brendena/apple_pi_tv/Images/apple_pi_tv_board2.png

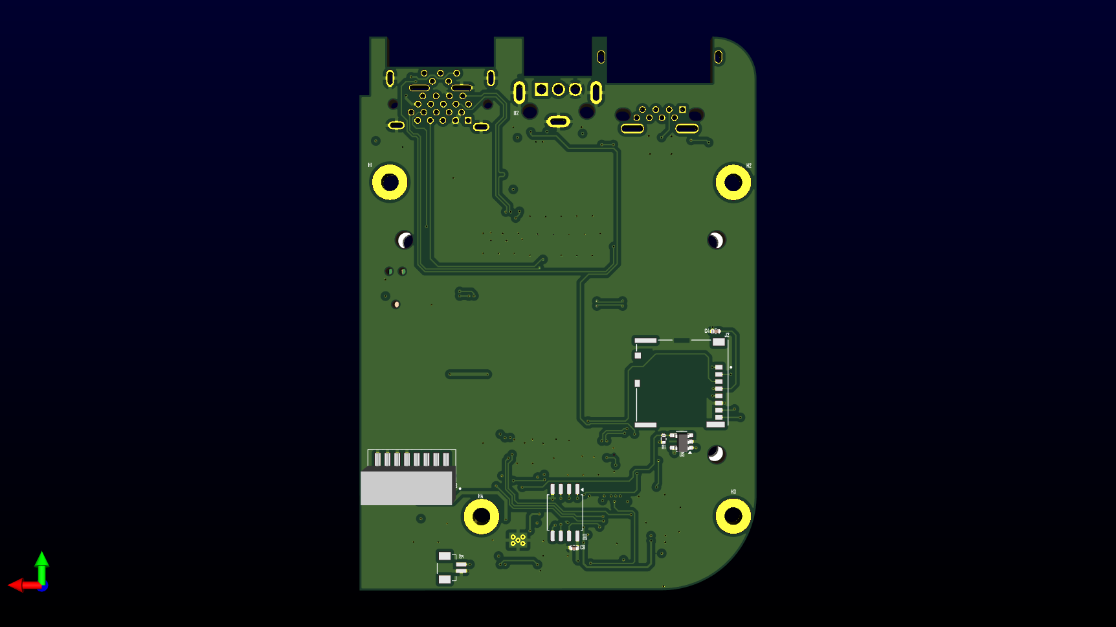
Images/apple_pi_tv_board2.png
