brendena/apple_pi_tv/Images/apple_pi_tv_board.png

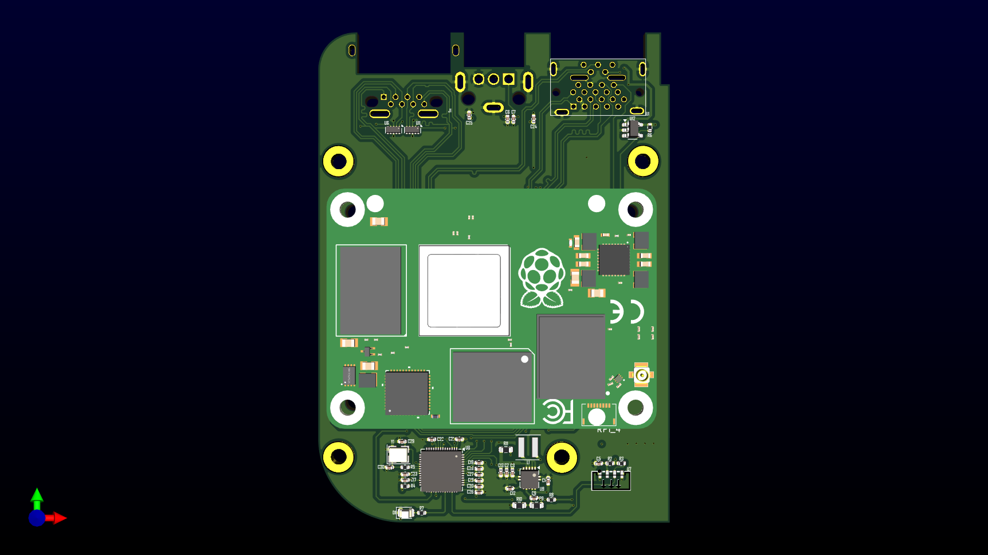
Images/apple_pi_tv_board.png
