brendena/apple_pi_tv/README.md

# apple pi tv
The goal is to make a replacement board for the apple tv using a raspberry pi CM4
