brendena/apple_pi_tv/board/apple_tv_hdmi_usb.png

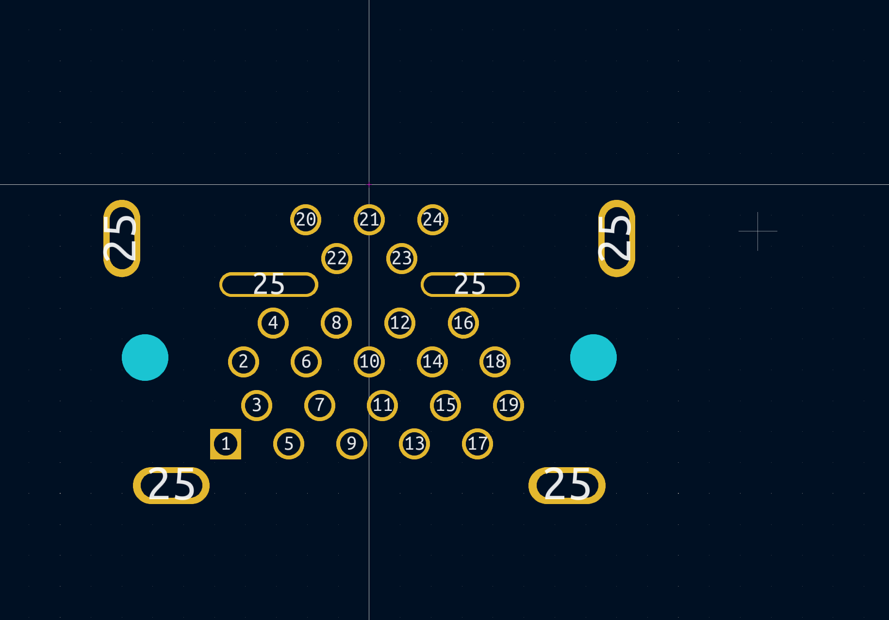
board/apple_tv_hdmi_usb.png
