brendena/apple_pi_tv/doc/images/layers.png

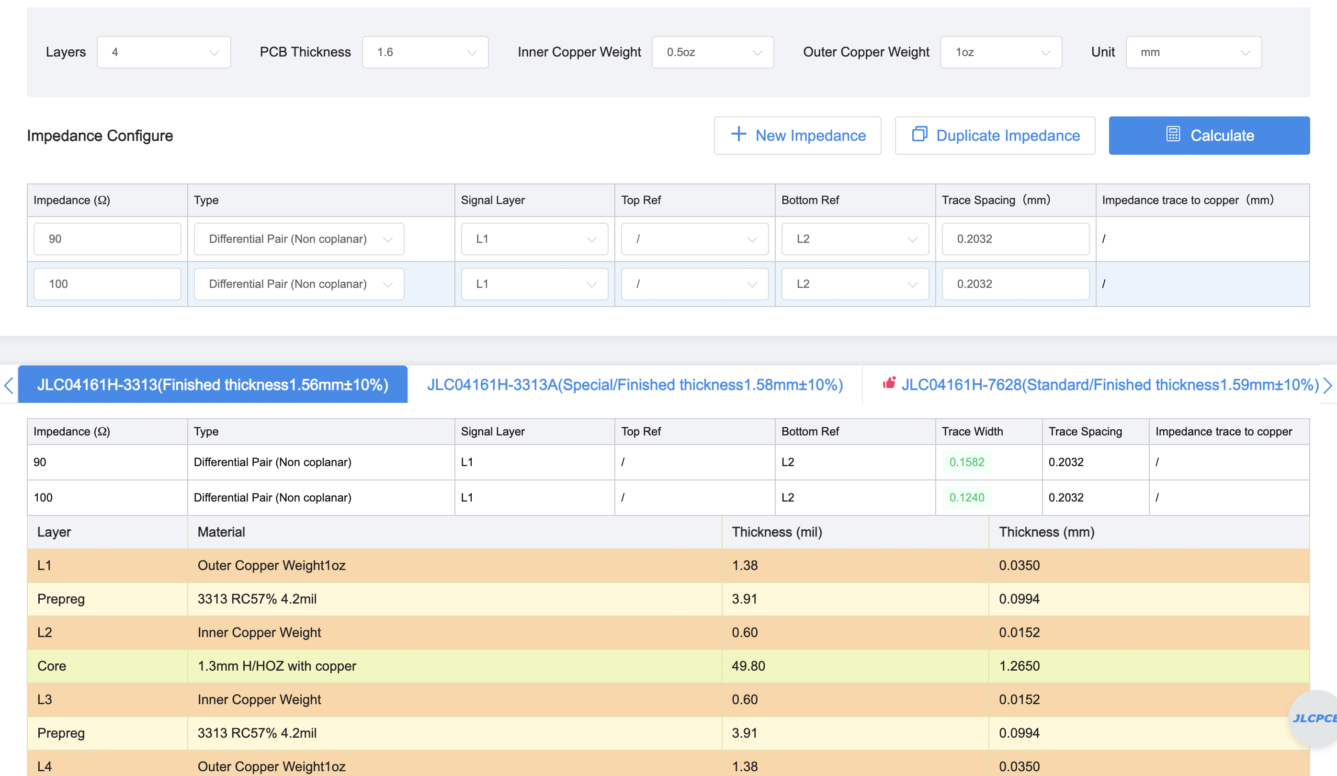
doc/images/layers.png
