brendena/apple_pi_tv/doc/images/ti_power_supply.png

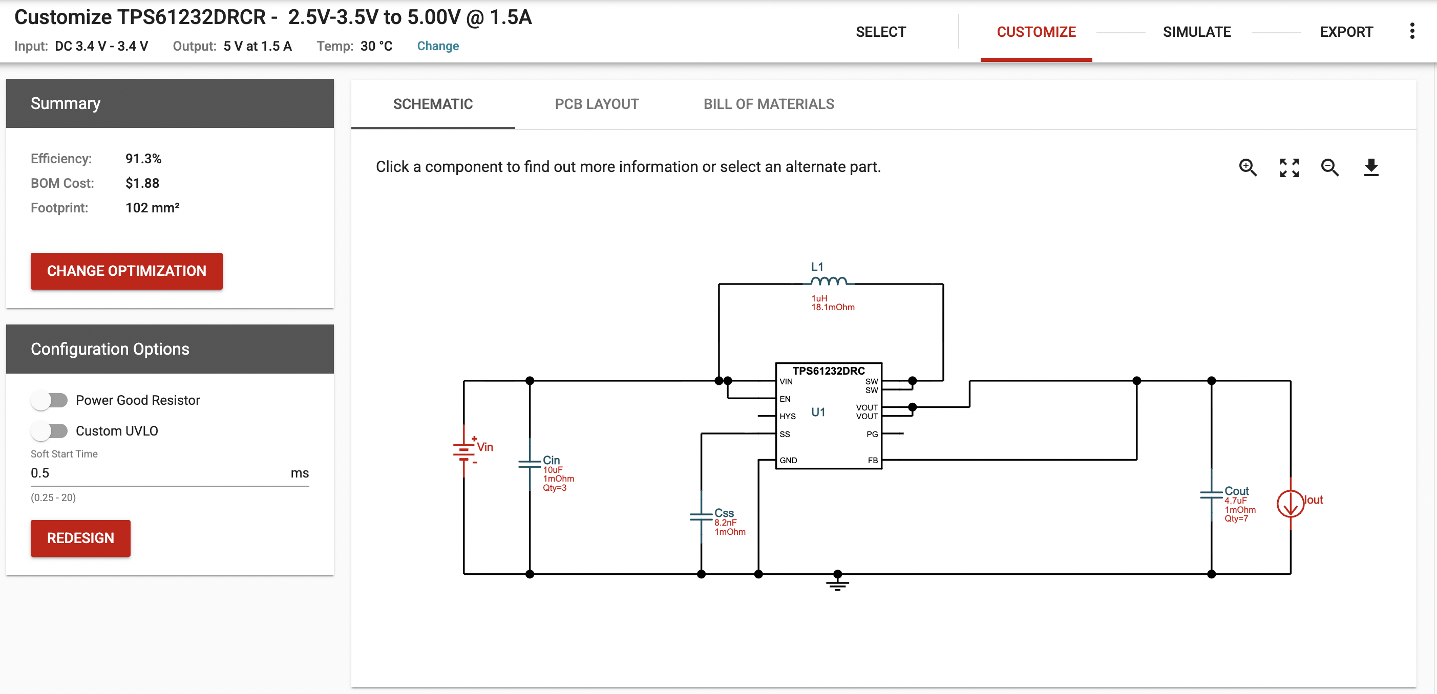
doc/images/ti_power_supply.png
