brendena/apple_pi_tv/doc/scans/back.jpg

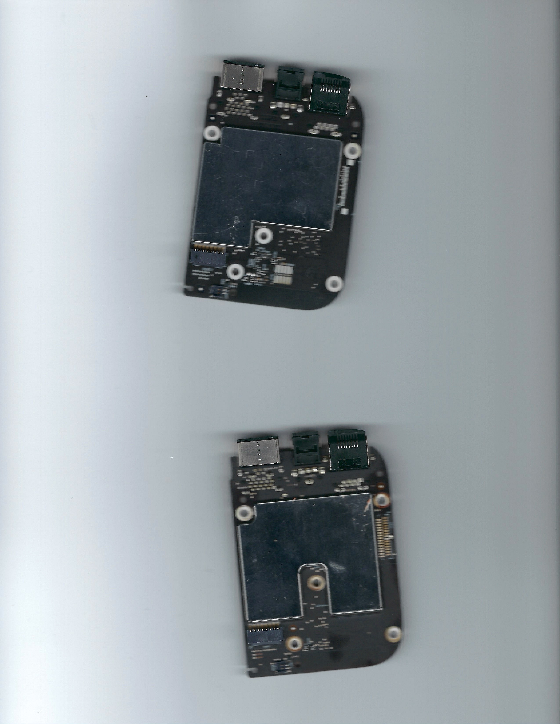
doc/scans/back.jpg
