brendena/apple_pi_tv/doc/scans/front.jpg

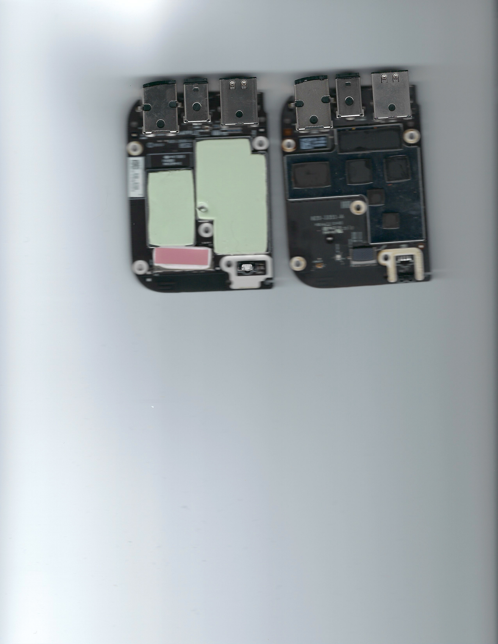
doc/scans/front.jpg
