brendena/apple_pi_tv/Images/apple_pi_tv_board5.png

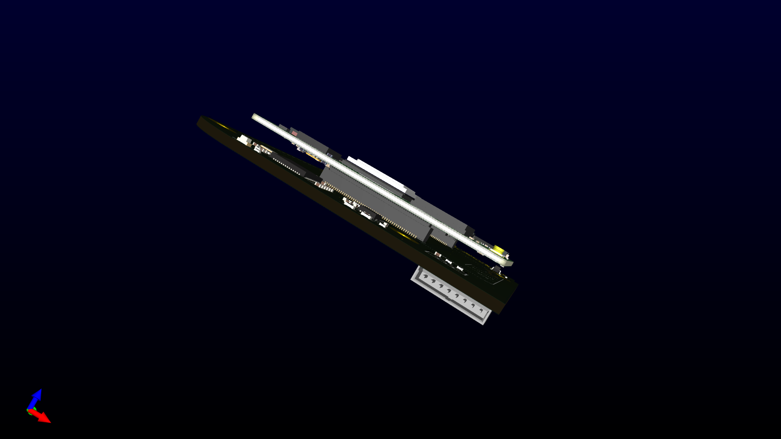
Images/apple_pi_tv_board5.png
