brendena/apple_pi_tv/Images/apple_pi_tv_board6.png

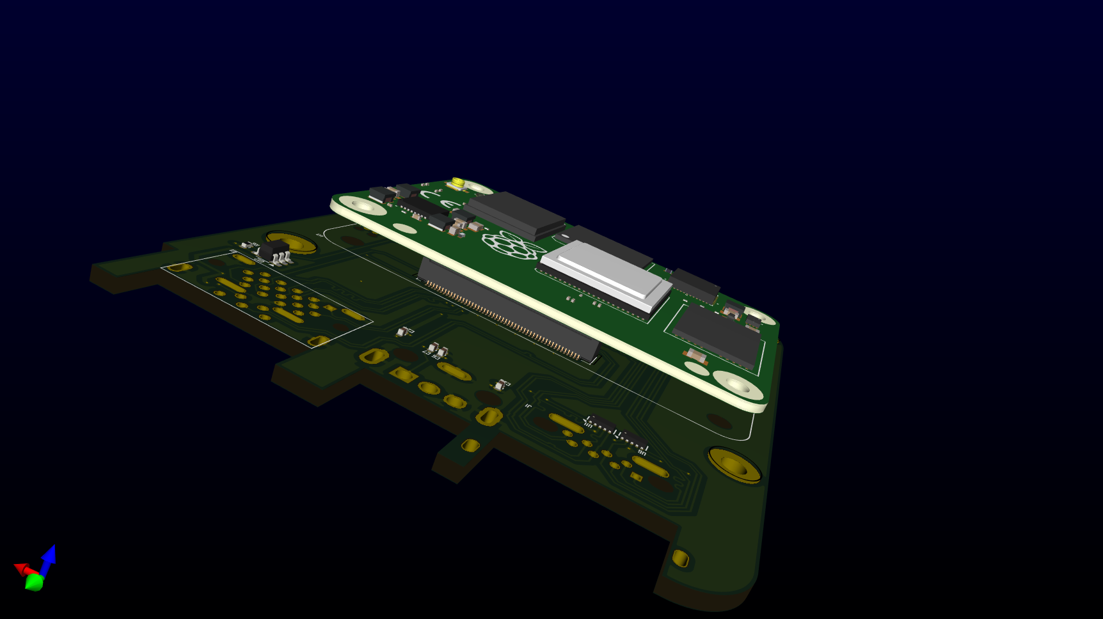
Images/apple_pi_tv_board6.png
