brendena/apple_pi_tv/board/apple_pi_tv_board.step

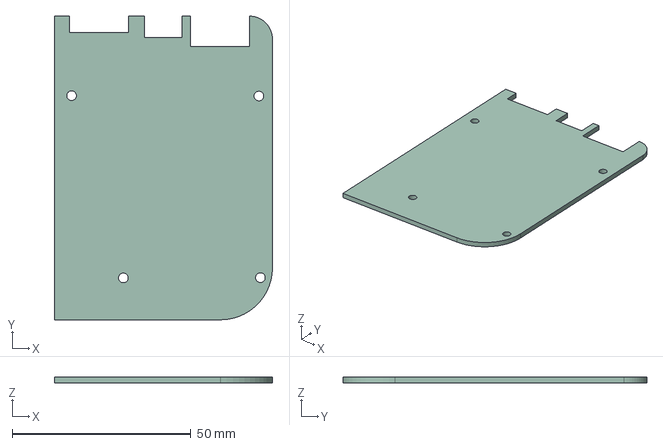
[picture p12: CAD file, 2024-07-14]
board/apple_pi_tv_board.step
61.0 x 85.0 x 1.60 mm
