brendena/apple_pi_tv/board/parts/DF40C-100DS-0.4V_51_/DF40C-100DS-0.4V_51_.step

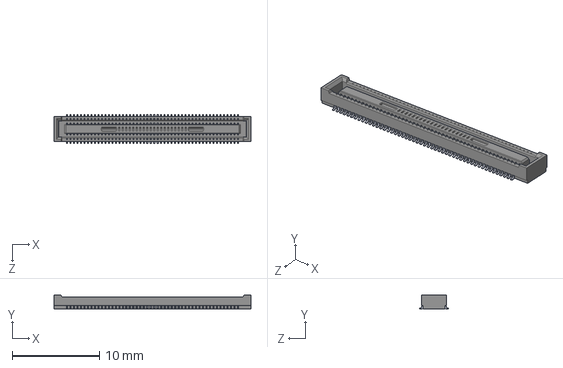
[picture p13: CAD file, 2026-08-02]
board/parts/DF40C-100DS-0.4V_51_/DF40C-100DS-0.4V_51_.step
22.6 x 1.65 x 3.38 mm
