brendena/apple_pi_tv/board/parts/H5007NL/H5007NL.step

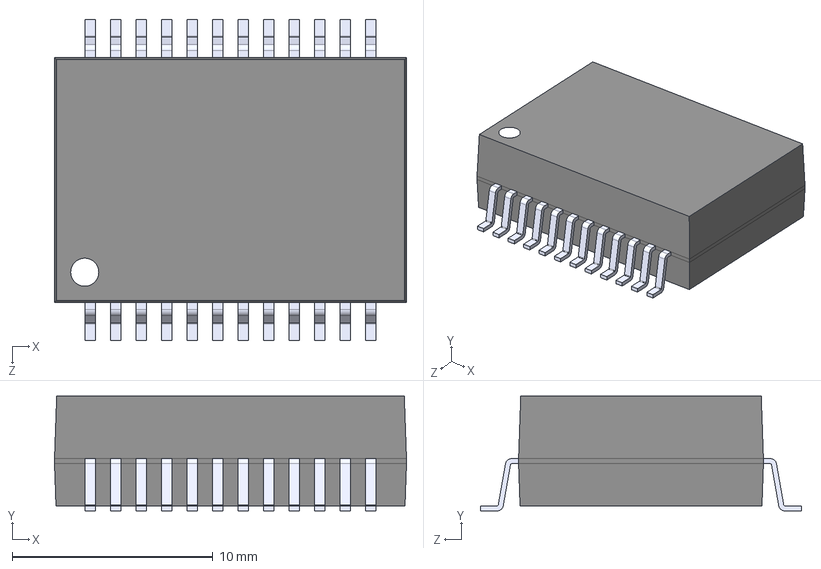
[picture p14: CAD file, 2025-11-13]
board/parts/H5007NL/H5007NL.step
17.5 x 5.72 x 16.0 mm
