brendena/apple_pi_tv/board/parts/RP2350_KiCad/RP2350B-QFN80.step

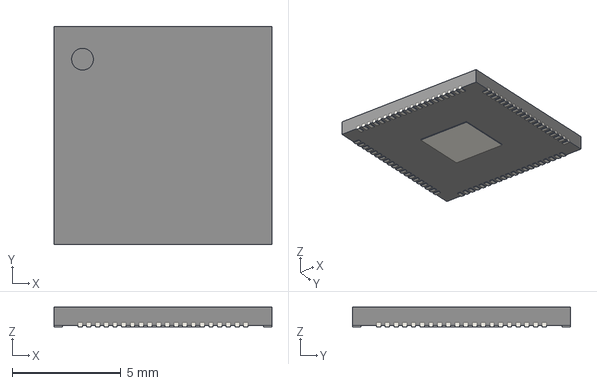
[picture p15: CAD file, 2025-09-10]
board/parts/RP2350_KiCad/RP2350B-QFN80.step
10.0 x 10.0 x 0.9 mm
