brendena/apple_pi_tv/board/parts/TF-01A/TF-01A.step

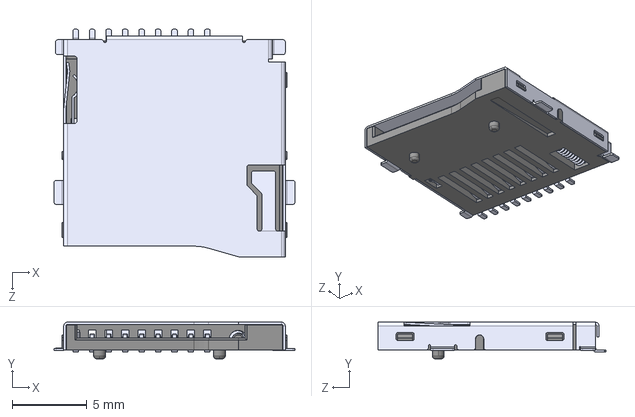
[picture p16: CAD file, 2025-12-14]
board/parts/TF-01A/TF-01A.step
16.1 x 2.45 x 15.2 mm
