brendena/apple_pi_tv/board/parts/RP2350_KiCad/RP2350A-QFN60.step

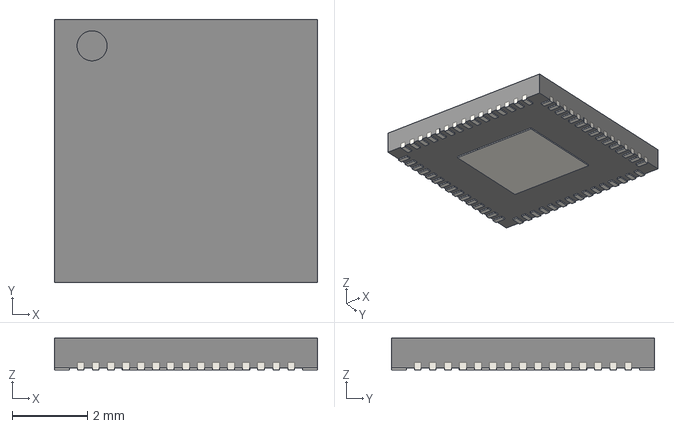
[picture p17: CAD file, 2025-09-10]
board/parts/RP2350_KiCad/RP2350A-QFN60.step
7.00 x 7.00 x 0.85 mm
