brendena/apple_pi_tv/changes.md

Changes

### 0.1 -> 0.2
* hdmi - Pins 2 and 3 had to swap - done
* hdmi,TOSLINK,Ethernet - many of the holes needed to be moved
* Ethernet - needed to be pushed back a lot
* many resisters needed to be moved for the pi pico.  They were just in the wrong spot
* TOSLINK - needed to be flipped horizontally
