brendena/apple_pi_tv/apple_pi_tv_board.pdf

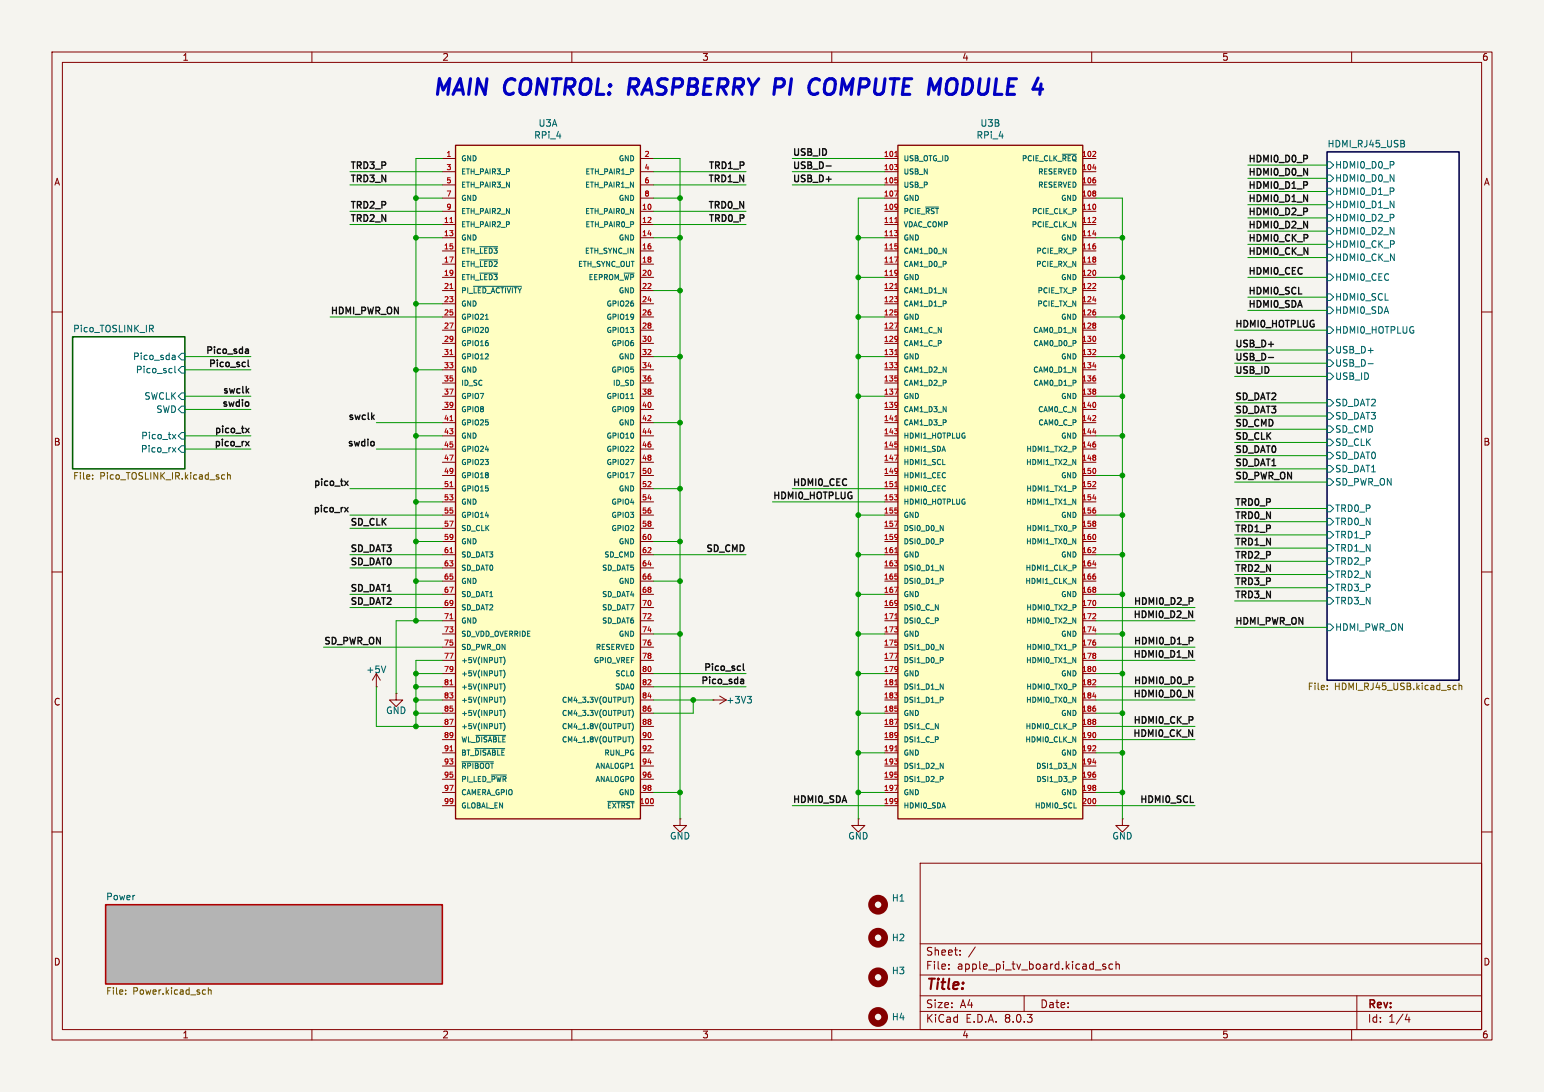
[picture p18: page 1]

File: HDMI_RJ45_USB.kicad_sch Power File: Power.kicad_sch

Id: 1/4 Title: File: apple_pi_tv_board.kicad_sch Sheet: /

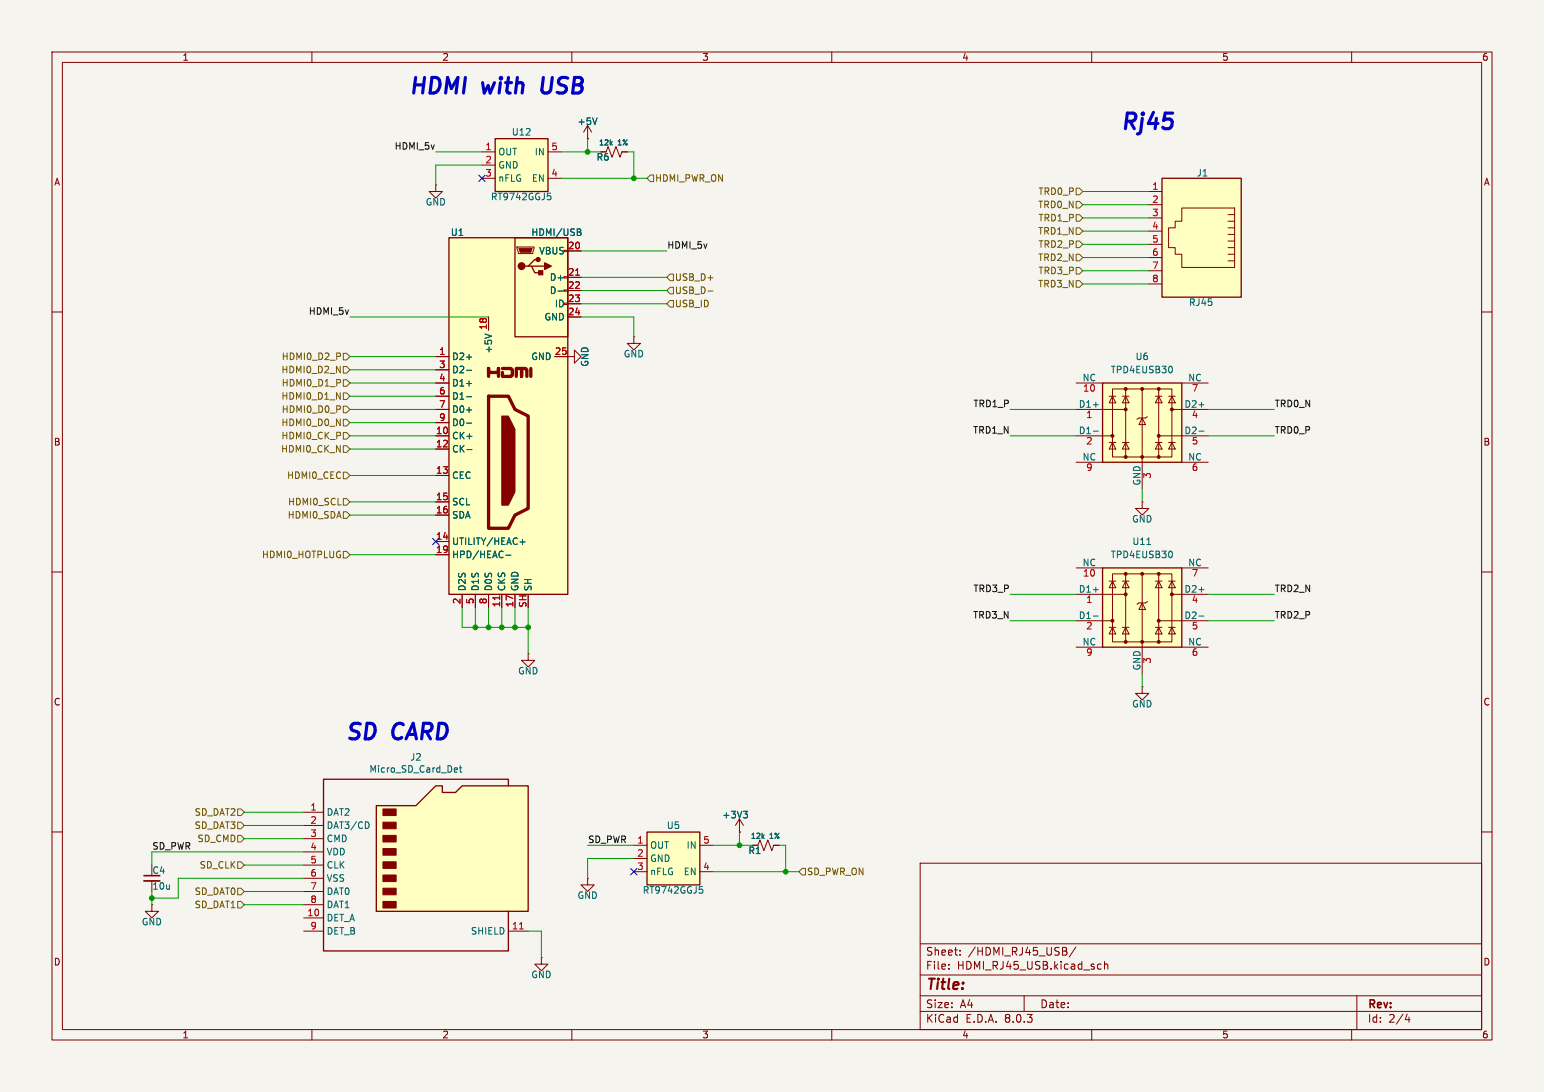
[picture p19: page 2]

Id: 2/4 Title: File: HDMI_RJ45_USB.kicad_sch Sheet: /HDMI_RJ45_USB/ GND

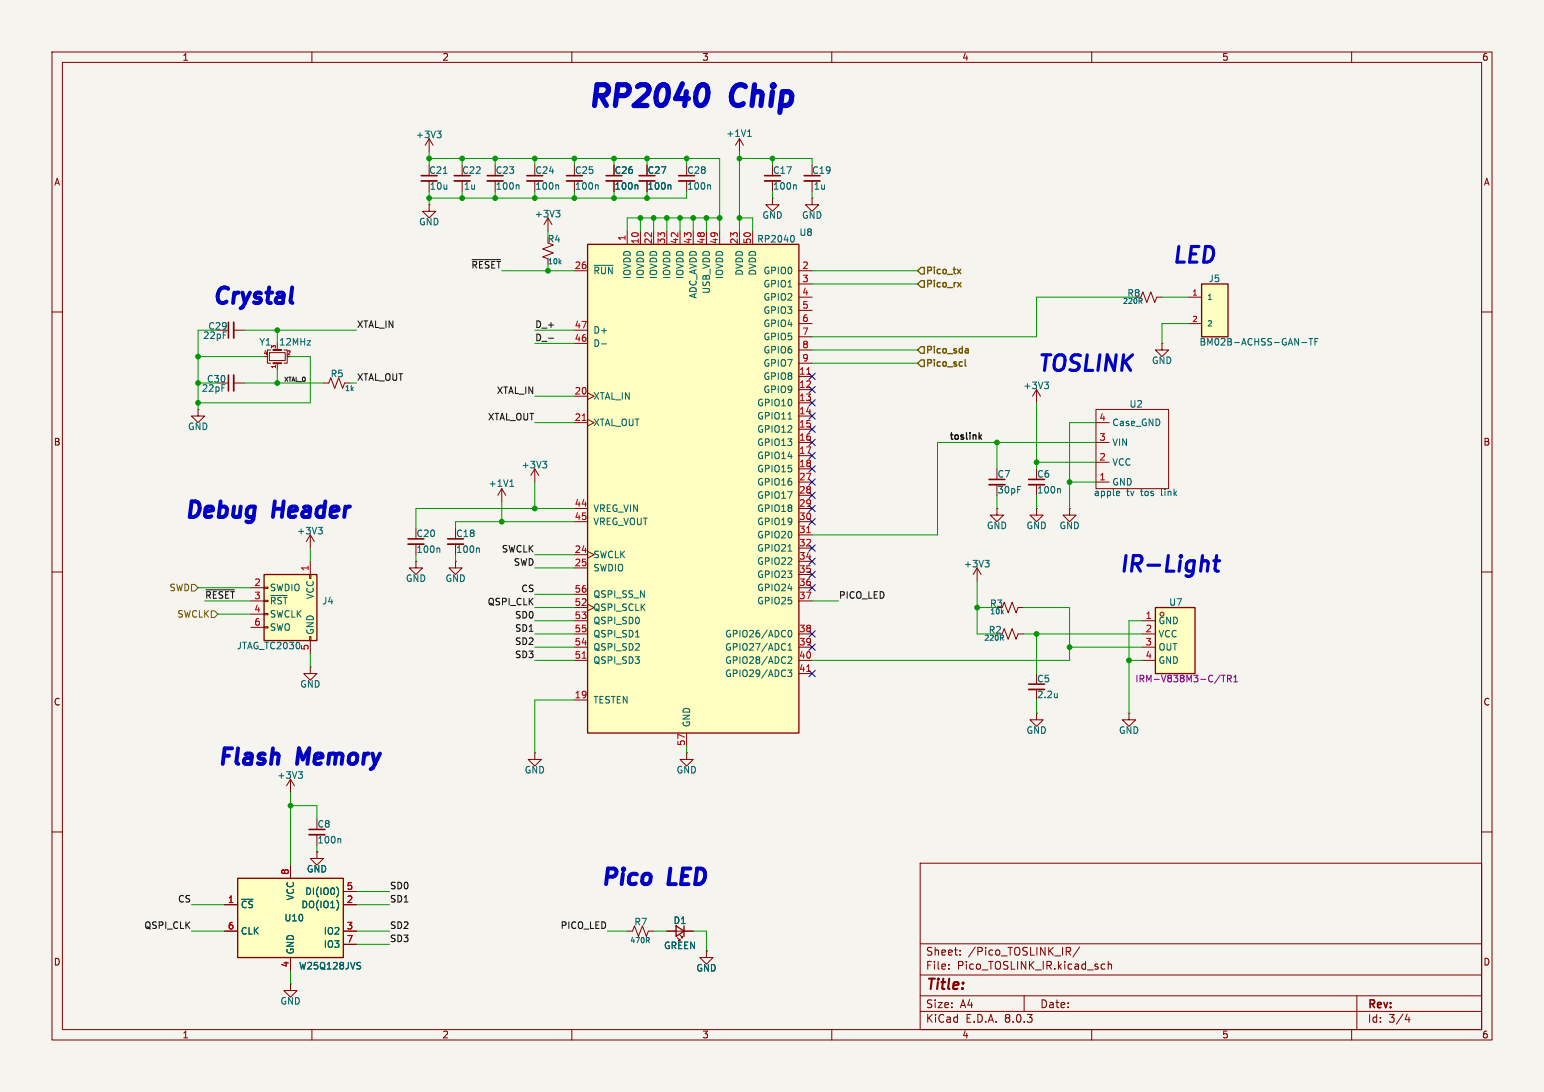
[picture p20: page 3]

1 IOVDD 10 GPIO8 11 GPIO9 12 GPIO10 13 GPIO11 14 GPIO12 15 GPIO13 16 GPIO14 17 GPIO15 18 TESTEN 19 GPIO0 2 XTAL_IN 20 XTAL_OUT 21 IOVDD 22 DVDD 23 SWCLK 24 SWDIO 25 ~{RUN} 26 GPIO16 27 GPIO17 28 GPIO18 29 GPIO1 3 GPIO19 30 GPIO20 31 GPIO21 32 IOVDD 33 GPIO22 34 GPIO23 35 GPIO24 36 GPIO25 37 GPIO26/ADC0 38 GPIO27/ADC1 39 GPIO2 4 GPIO28/ADC2 40 GPIO29/ADC3 41 IOVDD 42 ADC_AVDD 43 VREG_VIN 44 VREG_VOUT 45 D- 46 D+ 47 USB_VDD 48 IOVDD 49 GPIO3 5 DVDD 50 QSPI_SD3 51 QSPI_SCLK 52 QSPI_SD0 53 QSPI_SD2 54 QSPI_SD1 55 QSPI_SS_N 56 GND 57 GPIO4 6 GPIO5 7 GPIO6 8 GPIO7 9U8 RP2040 C19

apple tv tos link +3V3 GND

1 SWDIO 2 ~{RST} 3 SWCLK 4 GND

Id: 3/4 Title: File: Pico_TOSLINK_IR.kicad_sch Sheet: /Pico_TOSLINK_IR/

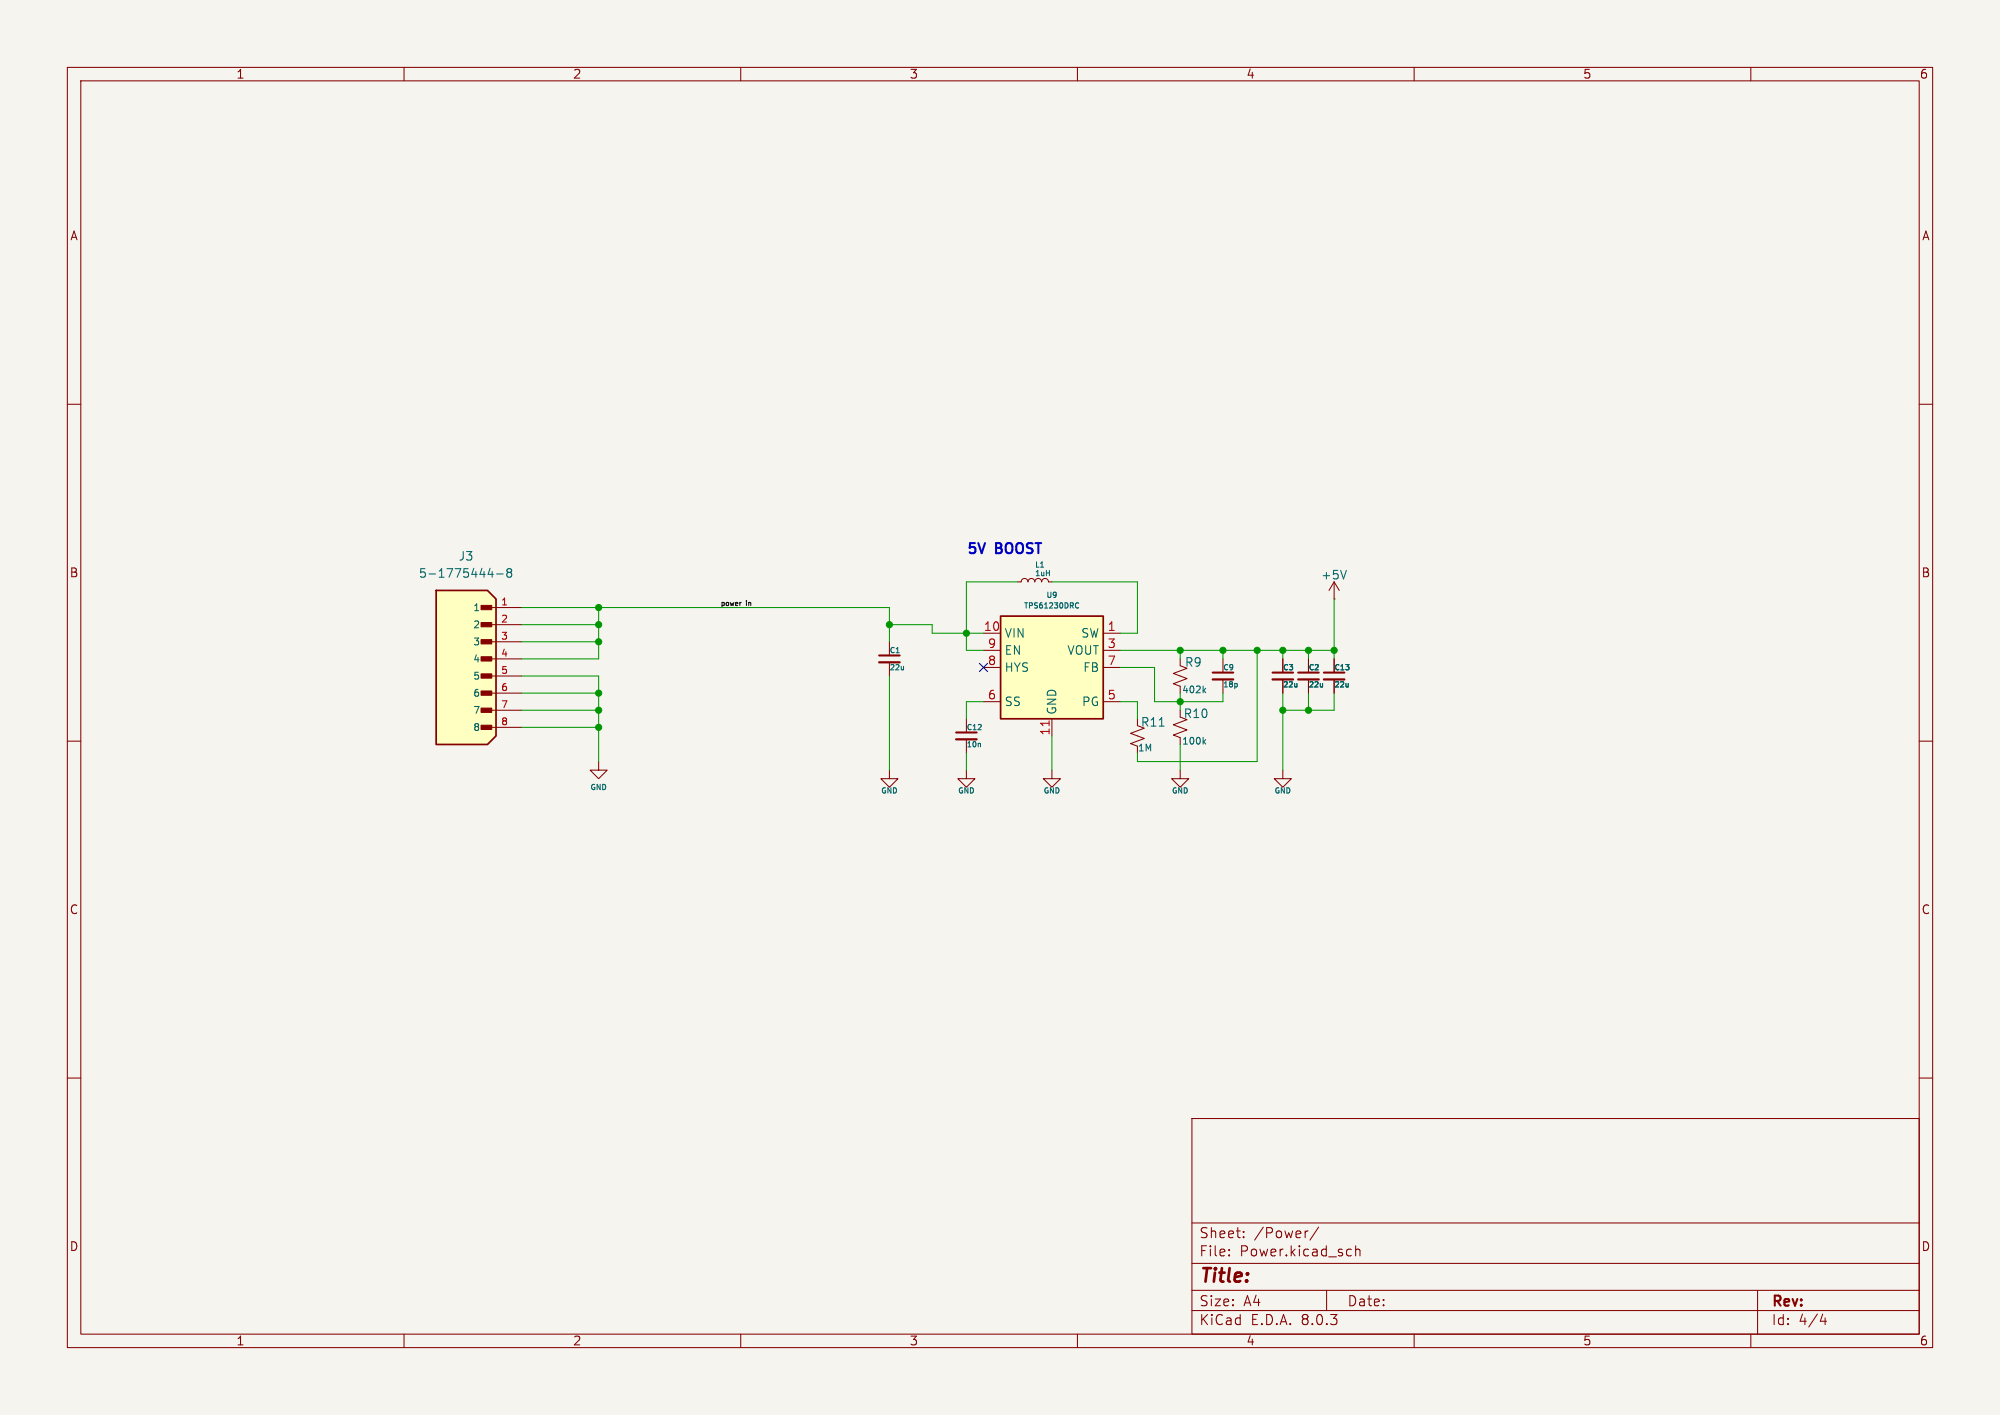
[picture p21: page 4]

Id: 4/4 Title: File: Power.kicad_sch Sheet: /Power/
