brendena/apple_pi_tv/board/apple_pi_tv_board.kicad_pcb

## KiCad design board/apple_pi_tv_board.kicad_pcb (2026-08-02)

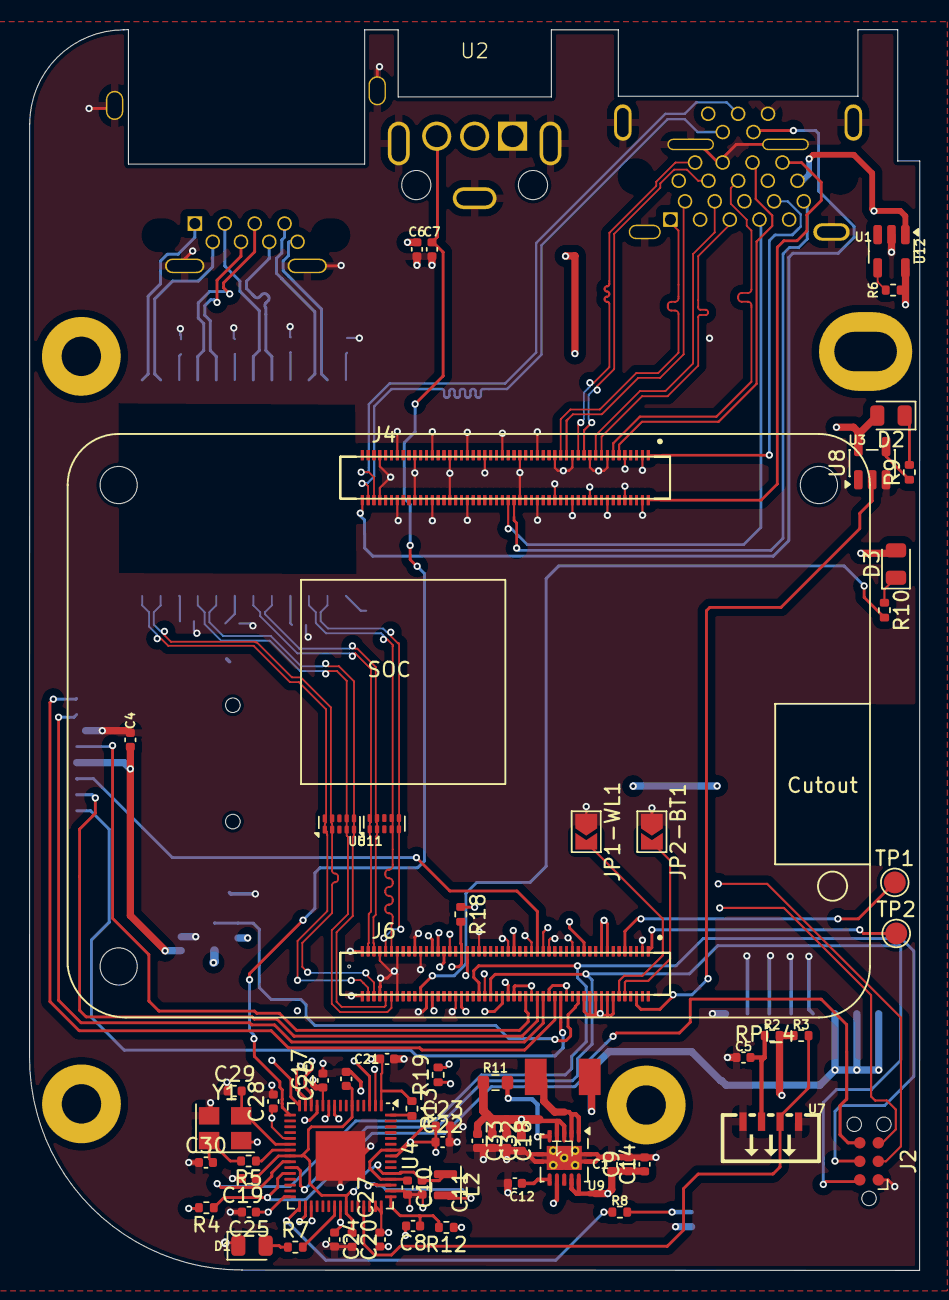
[picture p22: board apple_pi_tv_board.kicad_pcb from above]

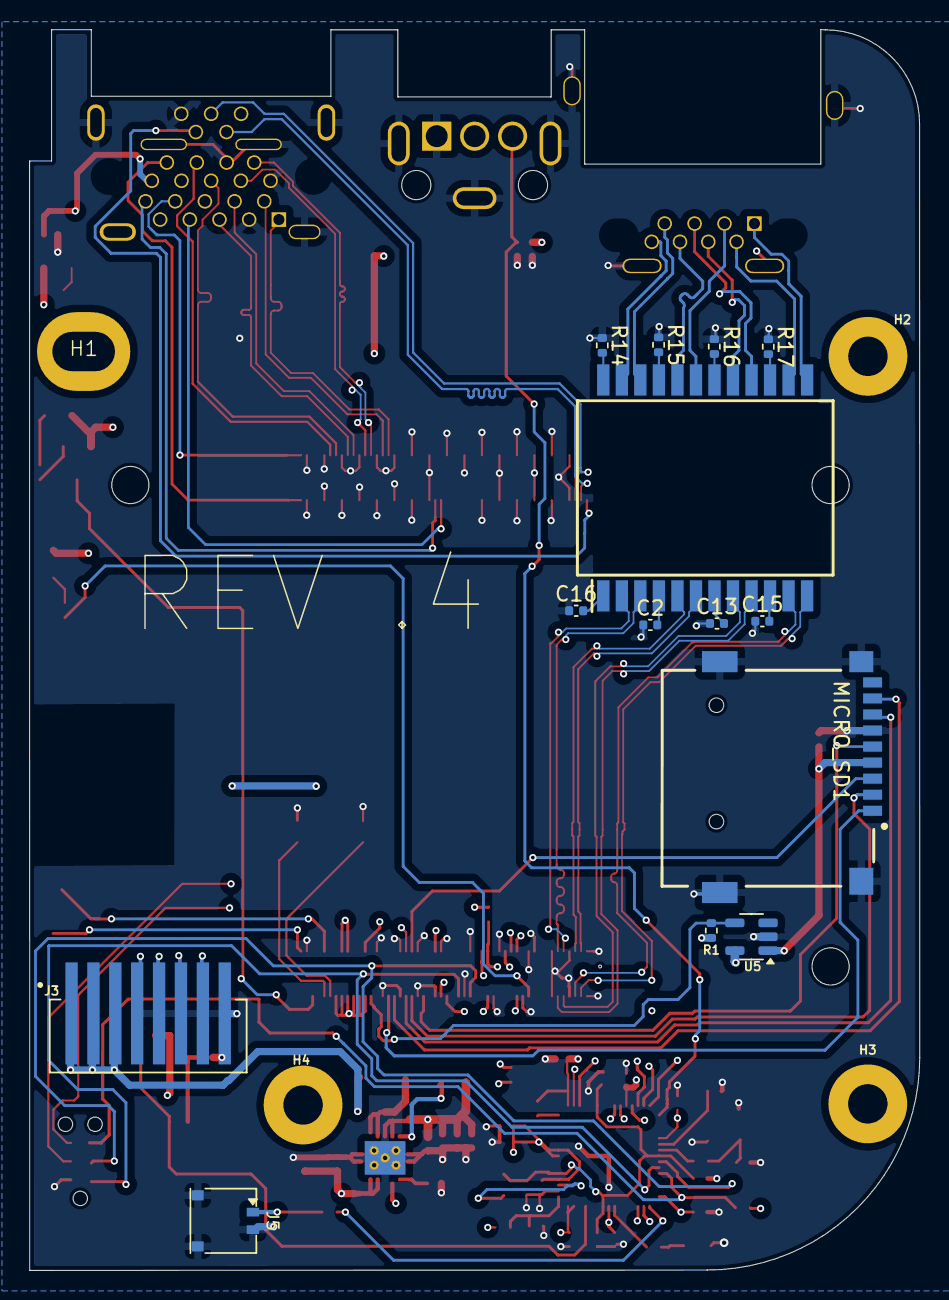
[picture p23: board apple_pi_tv_board.kicad_pcb from below]

Board: 4 copper layers, 61.0 x 85.1 mm, 84 parts (18 on the bottom side), 93 nets.

Parts:
C1, C4, C9, C14: 10u; C_0402_1005Metric
C2, C13, C15, C16: 0.1uf; C_0402_1005Metric
C3, C8, C10, C11, C18, C19: 4.7u; C_0402_1005Metric
C5: 2.2u; C_0402_1005Metric
C6, C17, C20, C21, C22, C23, C24, C25, C26, C27, C28: 100n; C_0402_1005Metric
C7: 30pF; C_0402_1005Metric
C12: 8.2nf; C_0402_1005Metric
C29, C30: 15pF; C_0402_1005Metric
C32, C33: 22u; C_0402_1005Metric
D1: GREEN; LED_0805_2012Metric
D2, D3: LED_Small; LED_0805_2012Metric
H1: MountingHole; ExtendedMountingHole
H2, H3, H4: MountingHole; MountingHole_2.7mm_Pad
J1: RJ45_Shielded; apple_tv_ethernet
J2: Dev_port; Tag-Connect_TC2030-IDC-NL_2x03_P1.27mm_Vertical
J3: 5-1775444-8; TE_5-1775444-8
J4, J6: DF40C-100DS-0.4V_51_; HIROSE_DF40C-100DS-0.4V_51_
J5: HDGC1202WR-S-2P; HDGC1202WR-S-02P
JP1-WL1, JP2-BT1: SolderJumper_2_Open; SolderJumper-2_P1.3mm_Open_TrianglePad1.0x1.5mm
L1: 1uH; MDA4020
L2: 3.3u; L_Murata_DFE201610P
MICRO_SD1: TF-01A
R1, R6: 12k 1%; R_0402_1005Metric
R2, R8, R18, R19: 220R; R_0402_1005Metric
R3, R4: 10k; R_0402_1005Metric
R5, R9, R10: 1k; R_0402_1005Metric
R7: 10K R; R_0402_1005Metric
R11: 100K; R_0603_1608Metric
R12: 33; R_0402_1005Metric
R13: 10K; R_0402_1005Metric
R14, R15, R16, R17: 75; R_0402_1005Metric
T1: H5007NL; SOIC127P1600X551-24N
TP1: RUN_PG; TestPoint_Pad_D1.5mm
TP2: Extrst; TestPoint_Pad_D1.5mm
U1: HDMI/USB; apple_tv_hdmi_usb
U2: apple tv tos link; apple_tv_tos_link
U3: RPi_4; RPI-CM4
U4: RP2354A; QFN-60-1EP_7x7mm_P0.4mm_EP3.4x3.4mm
U5, U12: RT9742GGJ5; SOT-23-5
U6, U11: TPD4EUSB30; USON-10_2.5x1.0mm_P0.5mm
U7: IRM-V838M3-C/TR1; OPTO-SMD_IRM-V838M3-C-TR1
U8: 74LVC1G07; SOT-23-5
U9: TPS61232DRC; Texas_S-PVSON-N10_ThermalVias
Y1: ABM8-272-T3; Crystal_SMD_3225-4Pin_3.2x2.5mm

Connections:
+1V1: C11.1, C17.1, C19.1, C20.1, L2.1, U4.6 (DVDD), U4.23 (DVDD), U4.39 (DVDD), U4.50 (VREG_FB)
+3V3: C6.1, C10.1, C21.1, C22.1, C23.1, C24.1, C25.1, C26.1, C27.1, C28.1, D2.2 (A), D3.2 (A), R1.1, R2.1, R3.1, R4.2, R12.1, R13.1, R18.1, R19.1, U2.2 (VCC), U3.78 (GPIO_VREF), U3.84 (CM4_3.3V(OUTPUT)), U3.86 (CM4_3.3V(OUTPUT)), U4.1 (IOVDD), U4.11 (IOVDD), U4.20 (IOVDD), U4.30 (IOVDD), U4.38 (IOVDD), U4.44 (ADC_AVDD), U4.45 (IOVDD), U4.49 (VREG_VIN), U4.53 (USB_OTP_VDD), U4.54 (QSPI_IOVDD), U5.5 (IN), U8.5 (VCC)
+5V: C3.1, C18.1, C32.1, C33.1, R6.1, R11.1, U3.77 (+5V(INPUT)), U3.79 (+5V(INPUT)), U3.81 (+5V(INPUT)), U3.83 (+5V(INPUT)), U3.85 (+5V(INPUT)), U3.87 (+5V(INPUT)), U9.3 (VOUT), U9.4 (VOUT), U9.7 (FB), U12.5 (IN)
/HDMI0_CEC: U1.13 (CEC), U3.151 (HDMI0_CEC)
/HDMI0_CK_N: U1.12 (CK-), U3.190 (HDMI0_CLK_N)
/HDMI0_CK_P: U1.10 (CK+), U3.188 (HDMI0_CLK_P)
/HDMI0_D0_N: U1.9 (D0-), U3.184 (HDMI0_TX0_N)
/HDMI0_D0_P: U1.7 (D0+), U3.182 (HDMI0_TX0_P)
/HDMI0_D1_N: U1.6 (D1-), U3.178 (HDMI0_TX1_N)
/HDMI0_D1_P: U1.4 (D1+), U3.176 (HDMI0_TX1_P)
/HDMI0_D2_N: U1.3 (D2-), U3.172 (HDMI0_TX2_N)
/HDMI0_D2_P: U1.1 (D2+), U3.170 (HDMI0_TX2_P)
/HDMI0_HOTPLUG: U1.19 (HPD/HEAC-), U3.153 (HDMI0_HOTPLUG)
/HDMI0_SCL: U1.15 (SCL), U3.200 (HDMI0_SCL)
/HDMI0_SDA: U1.16 (SDA), U3.199 (HDMI0_SDA)
/HDMI_PWR_ON: R6.2, U12.4 (EN)
/HDMI_RJ45_USB/HDMI_5v: U1.18 (+5V), U1.20 (VBUS), U12.1 (OUT)
/HDMI_RJ45_USB/MCT0: R14.2, T1.24 (MCT1)
/HDMI_RJ45_USB/MCT1: R15.2, T1.21 (MCT2)
/HDMI_RJ45_USB/MCT2: R16.2, T1.18 (MCT3)
/HDMI_RJ45_USB/MCT3: R17.2, T1.15 (MCT4)
/HDMI_RJ45_USB/MX0_N: J1.8, T1.23 (MX1+)
/HDMI_RJ45_USB/MX0_P: J1.7, T1.22 (MX1-)
/HDMI_RJ45_USB/MX1_N: J1.6, T1.20 (MX2+)
/HDMI_RJ45_USB/MX1_P: J1.3, T1.19 (MX2-)
/HDMI_RJ45_USB/MX2_N: J1.4, T1.17 (MX3+)
/HDMI_RJ45_USB/MX2_P: J1.5, T1.16 (MX3-)
/HDMI_RJ45_USB/MX3_N: J1.2, T1.14 (MX4+)
/HDMI_RJ45_USB/MX3_P: J1.1, T1.13 (MX4-)
/HDMI_RJ45_USB/SD_PWR: C4.1, MICRO_SD1.4 (VDD), U5.1 (OUT)
/I2S_CLK: U3.49 (GPIO18), U4.12 (GPIO8)
/I2S_LRCLK: U3.26 (GPIO19), U4.13 (GPIO9)
/I2S_OUT: U3.25 (GPIO21), U4.14 (GPIO10)
/PI_UART_TX: J2.3 (Pi_Tx), U3.51 (GPIO15)
/PI_eeprom_scl: R19.2, U3.35 (ID_SC), U4.10 (GPIO7)
/Pi_eeprom_sda: R18.2, U3.36 (ID_SD), U4.9 (GPIO6)
/Pico_TOSLINK_IR/PICO_LED: R7.2, U4.37 (GPIO25)
/Pico_TOSLINK_IR/Pico_blinky: R8.1, U4.31 (GPIO19)
/Pico_TOSLINK_IR/XTAL_IN: C29.2, U4.21 (XIN), Y1.3
/Pico_TOSLINK_IR/XTAL_O: C30.2, R5.2, Y1.1
/Pico_TOSLINK_IR/XTAL_OUT: R5.1, U4.22 (XOUT)
/Pico_TOSLINK_IR/toslink: C7.1, U2.3 (VIN), U4.16 (GPIO12)
/Pico_TOSLINK_IR/~RESET: J2.6 (RST), R4.1, U4.26 (RUN)
/Pico_hid_irq: U3.30 (GPIO6), U4.15 (GPIO11)
/Pico_scl: U3.28 (GPIO13), U4.33 (GPIO21)
/Pico_sda: U3.38 (GPIO11), U4.32 (GPIO20)
/Power/power in: C1.1, C9.1, C14.1, J3.1, J3.2, J3.3, L1.1, U9.9 (EN), U9.10 (VIN)
/SD_CLK: MICRO_SD1.5 (CLK), U3.57 (SD_CLK)
/SD_CMD: MICRO_SD1.3 (CMD), U3.62 (SD_CMD)
/SD_DAT0: MICRO_SD1.7 (DAT0), U3.63 (SD_DAT0)
/SD_DAT1: MICRO_SD1.8 (DAT1), U3.67 (SD_DAT1)
/SD_DAT2: MICRO_SD1.1 (DAT2), U3.69 (SD_DAT2)
/SD_DAT3: MICRO_SD1.2 (CD/DAT3), U3.61 (SD_DAT3)
/SD_PWR_ON: R1.2, U3.75 (SD_PWR_ON), U5.4 (EN)
/TRD0_N: T1.2 (TD1+), U3.10 (ETH_PAIR0_N), U11.5 (D2-)
/TRD0_P: T1.3 (TD1-), U3.12 (ETH_PAIR0_P), U11.4 (D2+)
/TRD1_N: T1.5 (TD2+), U3.6 (ETH_PAIR1_N), U11.2 (D1-)
/TRD1_P: T1.6 (TD2-), U3.4 (ETH_PAIR1_P), U11.1 (D1+)
/TRD2_N: T1.8 (TD3+), U3.9 (ETH_PAIR2_N), U6.5 (D2-)
/TRD2_P: T1.9 (TD3-), U3.11 (ETH_PAIR2_P), U6.4 (D2+)
/TRD3_N: T1.11 (TD4+), U3.5 (ETH_PAIR3_N), U6.2 (D1-)
/TRD3_P: T1.12 (TD4-), U3.3 (ETH_PAIR3_P), U6.1 (D1+)
/USB_D+: U1.21 (D+), U3.105 (USB_P)
/USB_D-: U1.22 (D-), U3.103 (USB_N)
/USB_ID: U1.23 (ID), U3.101 (USB_OTG_ID)
/pico_rx: U3.54 (GPIO4), U4.3 (GPIO1)
/pico_tx: J2.5 (Pico_Tx), U3.64 (SD_DAT5), U4.2 (GPIO0)
/swclk: J2.4 (SWCLK), U3.41 (GPIO25), U4.24 (SWCLK)
/swdio: J2.2 (SWD), U3.45 (GPIO24), U4.25 (SWDIO)
GND: C1.2, C2.1, C3.2, C4.2, C5.2, C6.2, C7.2, C8.2, C9.2, C10.2, C11.2, C12.2, C13.1, C14.2, C15.1, C16.1, C17.2, C18.2, C19.2, C20.2, C21.2, C22.2, C23.2, C24.2, C25.2, C26.2, C27.2, C28.2, C29.1, C30.1, C32.2, C33.2, D1.1 (K), J1.SH, J2.1 (GND), J3.4, J3.5, J3.6, J3.7, J3.8, J5.2, J5.MP, JP1-WL1.1 (A), JP2-BT1.1 (A), MICRO_SD1.6 (VSS), MICRO_SD1.MP1 (SHIELD), MICRO_SD1.MP2 (SHIELD), MICRO_SD1.MP3 (SHIELD), MICRO_SD1.MP4 (SHIELD), R14.1, R15.1, R16.1, R17.1, U1.2 (D2S), U1.5 (D1S), U1.8 (D0S), U1.11 (CKS), U1.17 (GND), U1.24 (GND), U1.25 (GND), U2.1 (GND), U2.4 (Case_GND), U3.1 (GND), U3.2 (GND), U3.7 (GND), U3.8 (GND), U3.13 (GND), U3.14 (GND), U3.20 (EEPROM_~WP), U3.22 (GND), U3.23 (GND), U3.32 (GND), U3.33 (GND), U3.42 (GND), U3.43 (GND), U3.52 (GND), U3.53 (GND), U3.59 (GND), U3.60 (GND), U3.65 (GND), U3.66 (GND), U3.71 (GND), U3.74 (GND), U3.98 (GND), U3.107 (GND), U3.108 (GND), U3.113 (GND), U3.114 (GND), U3.119 (GND), U3.120 (GND), U3.125 (GND), U3.126 (GND), U3.131 (GND), U3.132 (GND), U3.137 (GND), U3.138 (GND), U3.144 (GND), U3.150 (GND), U3.155 (GND), U3.156 (GND), U3.161 (GND), U3.162 (GND), U3.167 (GND), U3.168 (GND), U3.173 (GND), U3.174 (GND), U3.179 (GND), U3.180 (GND), U3.185 (GND), U3.186 (GND), U3.191 (GND), U3.192 (GND), U3.197 (GND), U3.198 (GND), U4.47 (VREG_PGND), U4.61 (GND), U5.2 (GND), U6.3 (GND), U6.8 (GND), U7.1 (GND), U7.4 (GND), U8.3 (GND), U9.11 (GND), U11.3 (GND), U11.8 (GND), U12.2 (GND), Y1.2, Y1.4
unnamed: D1.2 (A), R7.1
unnamed: D2.1 (K), R9.2
unnamed: D3.1 (K), R10.1
unnamed: J5.1, R8.2
unnamed: JP1-WL1.2 (B), U3.89 (WL_~DISABLE)
unnamed: JP2-BT1.2 (B), U3.91 (BT_~DISABLE)
unnamed: L1.2, U9.1 (SW), U9.2 (SW)
unnamed: R9.1, U8.4
unnamed: C16.2, T1.1 (TCT1)
unnamed: C2.2, T1.4 (TCT2)
unnamed: C13.2, T1.7 (TCT3)
unnamed: C15.2, T1.10 (TCT4)
unnamed: U3.95 (PI_LED_~PWR), U8.2
unnamed: R10.2, U3.21 (PI_~LED_ACTIVITY)
unnamed: TP1.1, U3.92 (RUN_PG)
unnamed: TP2.1, U3.100 (~EXTRST)
unnamed: R3.2, U4.42 (GPIO28_ADC2), U7.3 (OUT)
unnamed: R13.2, U4.60 (QSPI_SS)
unnamed: C8.1, R12.2, U4.46 (VREG_AVDD)
unnamed: L2.2, U4.48 (VREG_LX)
unnamed: C5.1, R2.2, U7.2 (VCC)
unnamed: R11.2, U9.5 (PG)
unnamed: C12.1, U9.6 (SS)
