brendena/apple_pi_tv/(commit log)

2024-07-14 got it almost looking good
    [apple_pi_tv_board.kicad_pcb, apple_pi_tv_board.kicad_sch, apple_pi_tv_board.step]
2024-07-27 moved the parts slightly
    [apple_pi_tv_board.kicad_pcb, apple_pi_tv_board.kicad_sch]
2024-08-24 added the board
    [HDMI_RJ45_USB.kicad_sch, Pico_TOSLINK_IR.kicad_sch, Power.kicad_sch, apple_pi_tv_board.kicad_pcb, apple_pi_tv_board.kicad_sch, apple_pi_tv_board.step]
2024-09-18 started working on rev 2
    [apple_pi_tv_board.kicad_pcb]
2024-10-03 got v2 done
    [apple_pi_tv_board.kicad_pcb]
2025-09-10 worked on new version with rp2350
    [HDMI_RJ45_USB.kicad_sch, Pico_TOSLINK_IR.kicad_sch, Power.kicad_sch, RP2350A-QFN60.step, RP2350B-QFN80.step, apple_pi_tv_board.kicad_pcb, apple_pi_tv_board.kicad_sch, bom.csv]
2025-09-13 updated most stuff, but i completely redid the diff pairs
    [HDMI_RJ45_USB.kicad_sch, Pico_TOSLINK_IR.kicad_sch, apple_pi_tv_board.kicad_pcb, apple_pi_tv_board.kicad_sch]
2025-09-14 almost v0.3
    [Pico_TOSLINK_IR.kicad_sch, Power.kicad_sch, apple_pi_tv_board.kicad_pcb, apple_pi_tv_board.kicad_sch, bom.csv, designators.csv, positions.csv]
2025-11-13 going to add the magnetic transformer which will messs a lot of stuff up
    [H5007NL.step, HDMI_RJ45_USB.kicad_sch, Power.kicad_sch, apple_pi_tv_board.kicad_pcb, apple_pi_tv_board.kicad_sch]
2025-12-07 started more ethernet adding stuff
    [HDMI_RJ45_USB.kicad_sch, apple_pi_tv_board.kicad_pcb, apple_pi_tv_board.kicad_sch]
2025-12-14 added the real micro sd card slot
    [HDMI_RJ45_USB.kicad_sch, TF-01A.step, apple_pi_tv_board.kicad_pcb, bom.csv, designators.csv, positions.csv]
2025-12-20 got the ethernet routed
    [HDMI_RJ45_USB.kicad_sch, apple_pi_tv_board.kicad_pcb, bom.csv, designators.csv, positions.csv]
2025-12-21 removed some via's
    [apple_pi_tv_board.kicad_pcb, apple_pi_tv_board.kicad_sch]
2025-12-23 made the cutout for the magnet isolater
    [apple_pi_tv_board.kicad_pcb]
2025-12-23 should be the last build
    [Power.kicad_sch, apple_pi_tv_board.kicad_pcb]
2026-08-02 most schematic is done
    [DF40C-100DS-0.4V_51_.step, HDMI_RJ45_USB.kicad_sch, Pico_TOSLINK_IR.kicad_sch, Power.kicad_sch, apple_pi_tv_board.kicad_pcb, apple_pi_tv_board.kicad_sch]
2026-08-02 almost ready to send out
    [Pico_TOSLINK_IR.kicad_sch, apple_pi_tv_board.kicad_pcb, apple_pi_tv_board.kicad_sch]
